RealCorebb/N20-MotorHall/MotorHall_BOM.csv

Designator | Footprint | Comments | Value | Supplier Part
C1 | C0603 | 100nF | 0603 100nF
CN1 | CONN-TH_6P-P1.25_HCTL_HC-1.25-6AW | Connectors(Optional) | 1.25mm-6P | C2845539
LED1 | LED_0603 | LED(Optional) | LED 0603 Whatever color you want
R1,R2 | R0603 | 1K | 0603 1KΩ
R3 | R0603 | 100Ω | 0603 100Ω
U1 | SIP-4_L5.3-W1.6-P1.27-L | Hall Sensor | MT1450A-EN (Tested) or A1230LK-T(Untested) | C19711152 / C696500
