RealCorebb/N20-MotorHall/MotorHall_Schematic.pdf

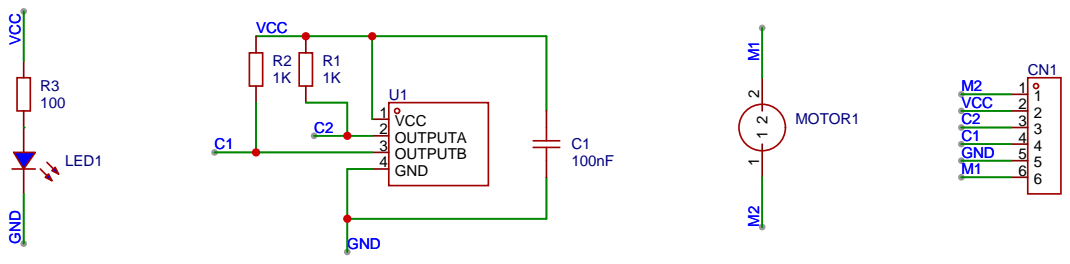
[picture p3: page 1]
