RealCorebb/N20-MotorHall/(list of files, drawings)

Other design files:
ProPrj_MotorHall.epro
